popiku14/Project-1-audio-input-preamplifier/Layout/Layout.PNG

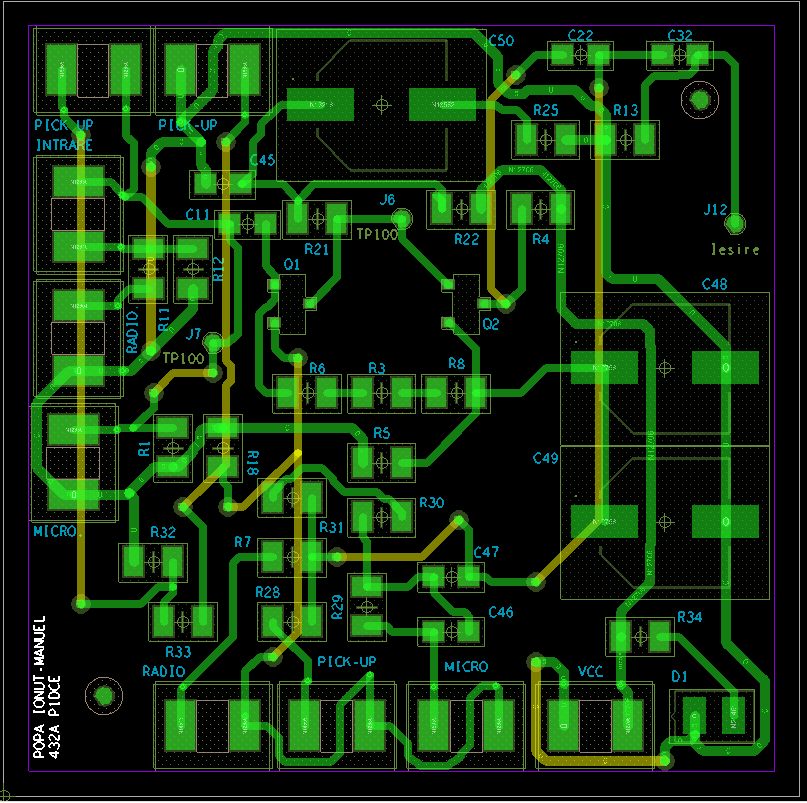
Layout/Layout.PNG
