popiku14/Project-1-audio-input-preamplifier/Schema Bloc.PNG

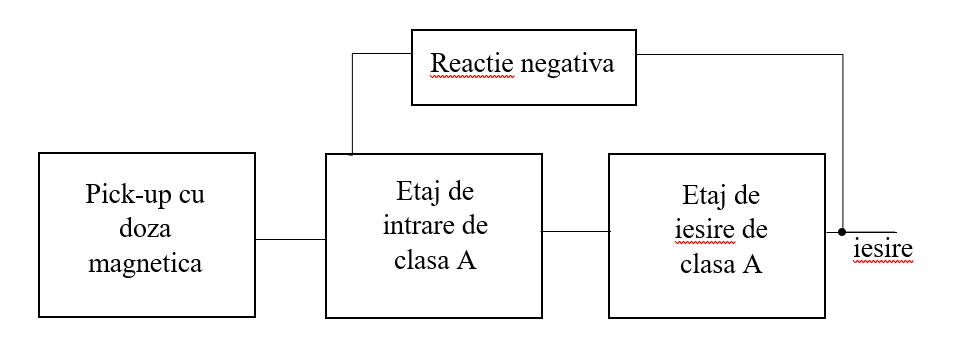
Schema Bloc.PNG
