popiku14/Project-1-audio-input-preamplifier/Simulations/simulare in frecventa.jpg

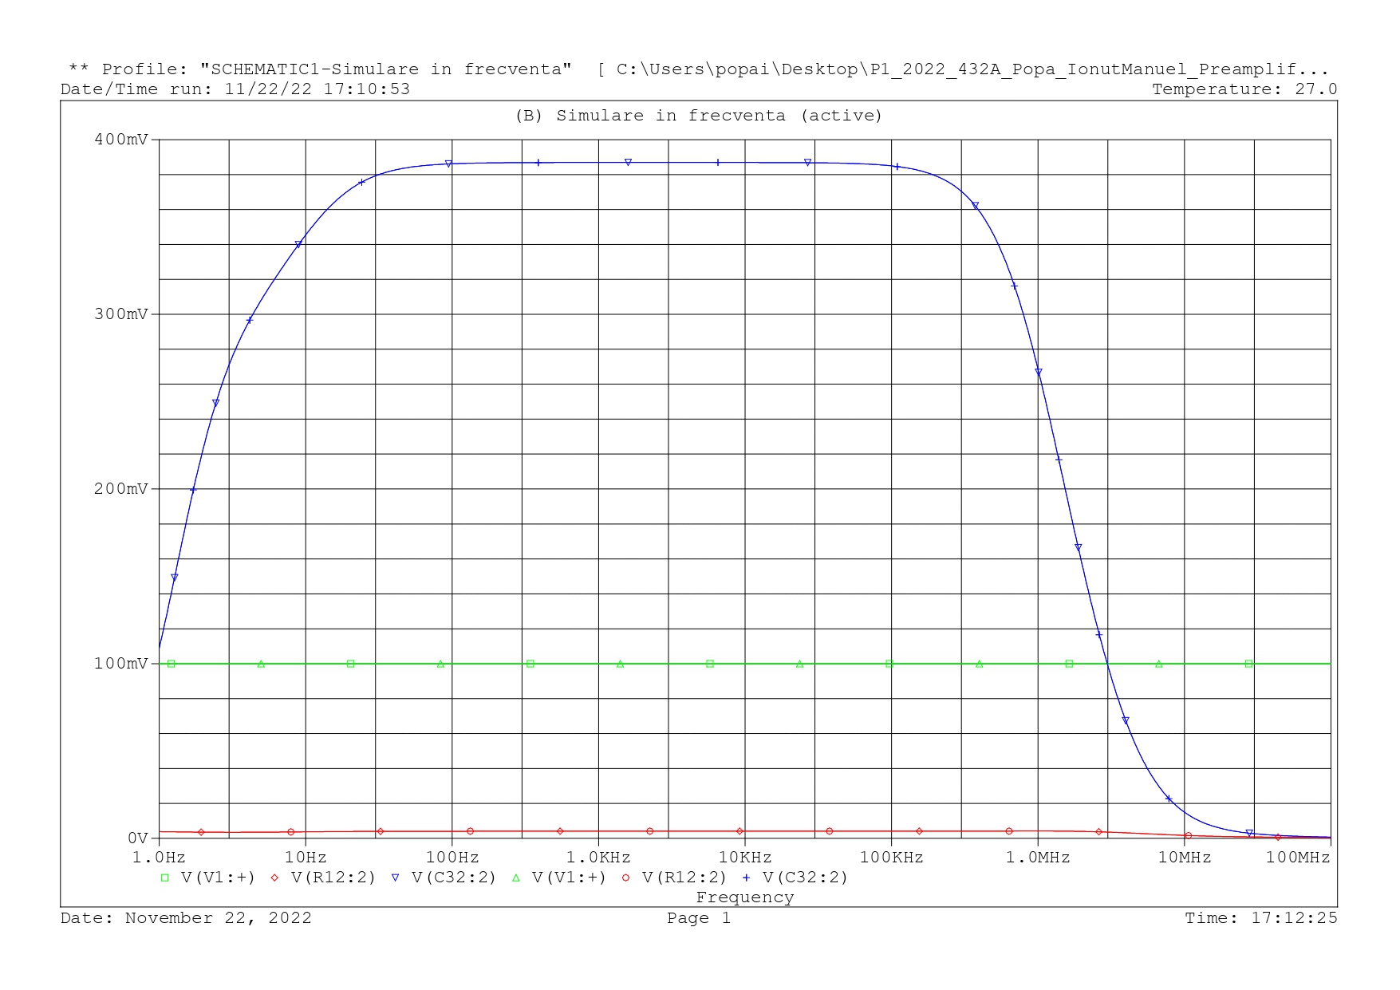
Simulations/simulare in frecventa.jpg
