popiku14/Project-1-audio-input-preamplifier/Simulations/simulare psf.png

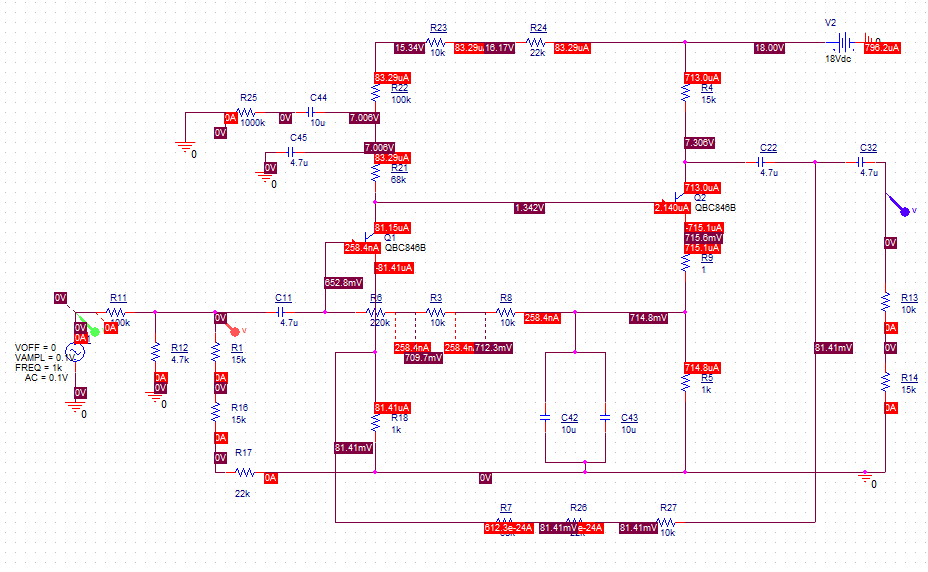
Simulations/simulare psf.png
