popiku14/Project-1-audio-input-preamplifier/Simulations/simulare tranzitorie (2).jpg

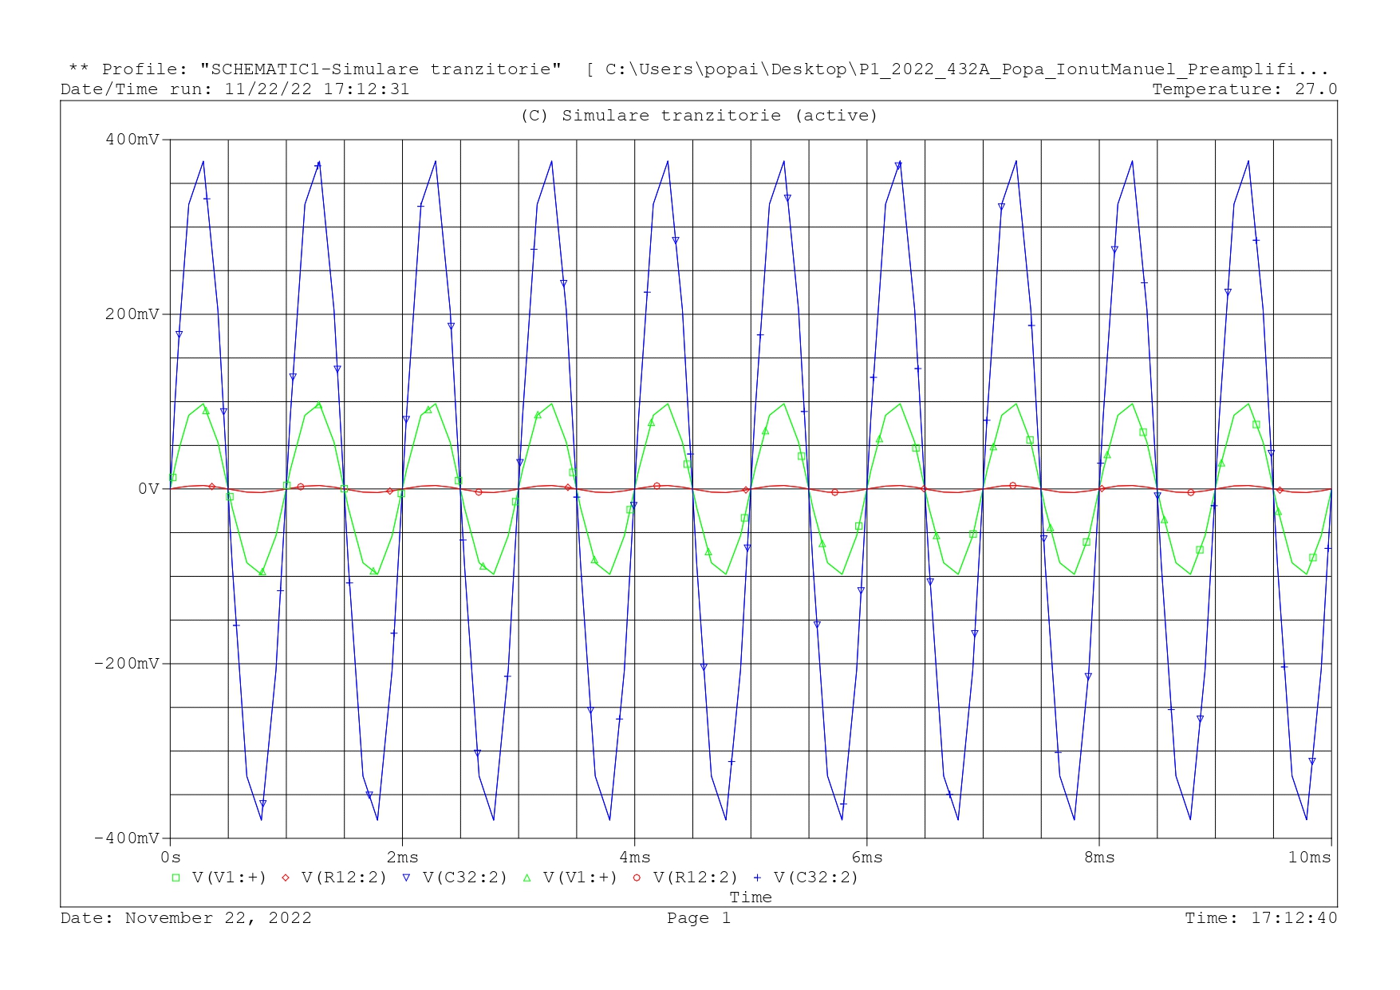
Simulations/simulare tranzitorie (2).jpg
