popiku14/Project-1-audio-input-preamplifier/Bill of materials/BOM.xlsx

Anexa a1 - Componente SMD disponibile pentru realizarea proiectului P1 - tehnologie SMT- AU 2021-2022
Nr. Crt. | Nume | Catalog | Cod distrib | Nume prod | Prod | Clasă | Descriere | Distribuitor | Cantitate
1 | 0 ohm | (LINK) (http://www.tme.eu/ro/details/smd1206-0r/rezistente-smd-1206/royal-ohm/1206s4j0000t5e/) | 1206S4J0000T5E | 1206S4J0000T5E | SR PASSIVES | rezistor | Rezistor: thick film; SMD; 1206; 0Ω; 0,25W; ±5%; -55÷125°C | TME România
2 | 0.47 | (LINK) (https://www.tme.eu/ro/details/0805s8j047kt5e/rezistente-smd-0805/royal-ohm/) | 0805S8J047KT5E | 0805S8J047KT5E | ROYAL OHM | rezistor | Rezistor: thick film; SMD; 0805; 470mΩ; 125mW; ±5%; -55÷125°C; 800ppm/°C | TME România
3 | 1 | (LINK) (https://www.tme.eu/ro/details/smd0805-1r/rezistente-smd-0805/royal-ohm/0805s8j010jt5e/) | SMD0805-1R | 0805S8J010JT5E | ROYAL OHM | rezistor | Rezistor: thick film; SMD; 0805; 1Ω; 0,125W; ±5%; -55÷125°C | TME România
4 | 4.7 | (LINK) (https://www.tme.eu/ro/details/smd0805-4r7/rezistente-smd-0805/royal-ohm/0805s8j047jt5e/) | SMD0805-4R7 | 0805S8J047JT5E | ROYAL OHM | rezistor | Rezistor: thick film; SMD; 0805; 4,7Ω; 0,125W; ±5%; -55÷125°C | TME România
5 | 10 | (LINK) (https://www.tme.eu/ro/details/smd0805-10r/rezistente-smd-0805/royal-ohm/0805s8j0100t5e/) | SMD0805-10R | 0805S8J0100T5E | ROYAL OHM | rezistor | Rezistor: thick film; SMD; 0805; 10Ω; 0,125W; ±5%; -55÷125°C | TME România
6 | 22 | (LINK) (https://www.tme.eu/ro/details/smd0805-22r-1%25/rezistente-smd-0805/royal-ohm/0805s8f220jt5e/) | SMD0805-22R-1% | 0805S8F220JT5E | ROYAL OHM | rezistor | Rezistor: thick film; SMD; 0805; 22Ω; 0,125W; ±1%; -55÷125°C | TME România
7 | 33 | (LINK) (https://www.tme.eu/ro/details/smd0805-33r/rezistente-smd-0805/royal-ohm/0805s8j0330t5e/) | SMD0805-33R | 0805S8J0330T5E | ROYAL OHM | rezistor | Rezistor: thick film; SMD; 0805; 33Ω; 0,125W; ±5%; -55÷125°C | TME România
8 | 51 | (LINK) (https://www.tme.eu/ro/details/0805s8j0510t5e/rezistente-smd-0805/royal-ohm/) | 0805S8J0510T5E | 0805S8J0510T5E | ROYAL OHM | rezistor | Rezistor: thick film; SMD; 0805; 51Ω; 0,125W; ±5%; -55÷155°C; 200ppm/°C | TME România
9 | 68 | (LINK) (https://www.tme.eu/ro/details/smd0805-68r/rezistente-smd-0805/royal-ohm/0805s8j0680t5e/) | SMD0805-68R | 0805S8J0680T5E | ROYAL OHM | rezistor | Rezistor: thick film; SMD; 0805; 68Ω; 0,125W; ±5%; -55÷125°C | TME România
10 | 82 | (LINK) (https://www.tme.eu/ro/details/smd0805-82r/rezistente-smd-0805/royal-ohm/0805s8j0820t5e/) | SMD0805-82R | 0805S8J0820T5E | ROYAL OHM | rezistor | Rezistor: thick film; SMD; 0805; 82Ω; 0,125W; ±5%; -55÷125°C | TME România
11 | 100 | (LINK) (https://www.tme.eu/ro/details/smd0805-100r/rezistente-smd-0805/royal-ohm/0805s8j0101t5e/) | SMD0805-100R | 0805S8J0101T5E | ROYAL OHM | rezistor | Rezistor: thick film; SMD; 0805; 100Ω; 0,125W; ±5%; -55÷125°C | TME România
12 | 150 | (LINK) (https://www.tme.eu/ro/details/smd0805-150r/rezistente-smd-0805/royal-ohm/0805s8j0151t5e/) | SMD0805-150R | 0805S8J0151T5E | ROYAL OHM | rezistor | Rezistor: thick film; SMD; 0805; 150Ω; 0,125W; ±5%; -55÷125°C | TME România
13 | 220 | (LINK) (https://www.tme.eu/ro/details/smd0805-220r/rezistente-smd-0805/royal-ohm/0805s8j0221t5e/) | SMD0805-220R | 0805S8J0221T5E | ROYAL OHM | rezistor | Rezistor: thick film; SMD; 0805; 220Ω; 0,125W; ±5%; -55÷125°C | TME România
14 | 330 | (LINK) (https://www.tme.eu/ro/details/smd0805-330r/rezistente-smd-0805/royal-ohm/0805s8j0331t5e/) | SMD0805-330R | 0805S8J0331T5E | ROYAL OHM | rezistor | Rezistor: thick film; SMD; 0805; 330Ω; 0,125W; ±5%; -55÷125°C | TME România
15 | 470 | (LINK) (https://www.tme.eu/ro/details/smd0805-470r/rezistente-smd-0805/royal-ohm/0805s8j0471t5e/) | SMD0805-470R | 0805S8J0471T5E | ROYAL OHM | rezistor | Rezistor: thick film; SMD; 0805; 470Ω; 0,125W; ±5%; -55÷125°C | TME România
16 | 510 | (LINK) (https://www.tme.eu/ro/details/smd0805-510r/rezistente-smd-0805/royal-ohm/0805s8j0511t5e/) | SMD0805-510R | 0805S8J0511T5E | ROYAL OHM | rezistor | Rezistor: thick film; SMD; 0805; 510Ω; 0,125W; ±5%; -55÷125°C | TME România
17 | 680 | (LINK) (https://www.tme.eu/ro/details/smd0805-680r/rezistente-smd-0805/royal-ohm/0805s8j0681t5e/) | SMD0805-680R | 0805S8J0681T5E | ROYAL OHM | rezistor | Rezistor: thick film; SMD; 0805; 680Ω; 0,125W; ±5%; -55÷125°C | TME România
18 | 820 | (LINK) (https://www.tme.eu/ro/details/smd0805-820r/rezistente-smd-0805/royal-ohm/0805s8j0821t5e/) | SMD0805-820R | 0805S8J0821T5E | ROYAL OHM | rezistor | Rezistor: thick film; SMD; 0805; 820Ω; 0,125W; ±5%; -55÷125°C | TME România
19 | 910 | (LINK) (https://www.tme.eu/ro/details/smd0805-910r/rezistente-smd-0805/royal-ohm/0805s8j0911t5e/) | SMD0805-910R | 0805S8J0911T5E | ROYAL OHM | rezistor | Rezistor: thick film; SMD; 0805; 910Ω; 0,125W; ±5%; -55÷125°C | TME România
20 | 1k | (LINK) (https://www.tme.eu/ro/details/smd0805-1k/rezistente-smd-0805/royal-ohm/0805s8j0102t5e/) | SMD0805-1K | 0805S8J0102T5E | ROYAL OHM | rezistor | Rezistor: thick film; SMD; 0805; 1kΩ; 0,125W; ±5%; -55÷125°C | TME România | 3
21 | 1.5k | (LINK) (https://www.tme.eu/ro/details/smd0805-1k5/rezistente-smd-0805/royal-ohm/0805s8j0152t5e/) | SMD0805-1K5 | 0805S8J0152T5E | ROYAL OHM | rezistor | Rezistor: thick film; SMD; 0805; 1,5kΩ; 0,125W; ±5%; -55÷125°C | TME România
22 | 1.8k | (LINK) (https://www.tme.eu/ro/details/smd0805-1k8/rezistente-smd-0805/royal-ohm/0805s8j0182t5e/) | SMD0805-1K8 | 0805S8J0182T5E | ROYAL OHM | rezistor | Rezistor: thick film; SMD; 0805; 1,8kΩ; 0,125W; ±5%; -55÷125°C | TME România
23 | 2k | (LINK) (https://www.tme.eu/ro/details/smd0805-2k/rezistente-smd-0805/royal-ohm/0805s8j0202t5e/) | SMD0805-2K | 0805S8J0202T5E | ROYAL OHM | rezistor | Rezistor: thick film; SMD; 0805; 2kΩ; 0,125W; ±5%; -55÷125°C | TME România
24 | 2.2k | (LINK) (https://www.tme.eu/ro/details/smd0805-2k2/rezistente-smd-0805/royal-ohm/0805s8j0222t5e/) | SMD0805-2K2 | 0805S8J0222T5E | ROYAL OHM | rezistor | Rezistor: thick film; SMD; 0805; 2,2kΩ; 0,125W; ±5%; -55÷125°C | TME România
25 | 2.7k | (LINK) (https://www.tme.eu/ro/details/smd0805-2k7/rezistente-smd-0805/royal-ohm/0805s8j0272t5e/) | SMD0805-2K7 | 0805S8J0272T5E | ROYAL OHM | rezistor | Rezistor: thick film; SMD; 0805; 2,7kΩ; 0,125W; ±5%; -55÷125°C | TME România
26 | 3.3k | (LINK) (https://www.tme.eu/ro/details/smd0805-3k3/rezistente-smd-0805/royal-ohm/0805s8j0332t5e/) | SMD0805-3K3 | 0805S8J0332T5E | ROYAL OHM | rezistor | Rezistor: thick film; SMD; 0805; 3,3kΩ; 0,125W; ±5%; -55÷125°C | TME România
27 | 3.9k | (LINK) (https://www.tme.eu/ro/details/smd0805-3k9/rezistente-smd-0805/royal-ohm/0805s8j0392t5e/) | SMD0805-3K9 | 0805S8J0392T5E | ROYAL OHM | rezistor | Rezistor: thick film; SMD; 0805; 3,9kΩ; 0,125W; ±5%; -55÷125°C | TME România
28 | 4.7k | (LINK) (https://www.tme.eu/ro/details/smd0805-4k7/rezistente-smd-0805/royal-ohm/0805s8j0472t5e/) | SMD0805-4K7 | 0805S8J0472T5E | ROYAL OHM | rezistor | Rezistor: thick film; SMD; 0805; 4,7kΩ; 0,125W; ±5%; -55÷125°C | TME România | 1
29 | 5.6k | (LINK) (https://www.tme.eu/ro/details/smd0805-5k6/rezistente-smd-0805/royal-ohm/0805s8j0562t5e/) | SMD0805-5K6 | 0805S8J0562T5E | ROYAL OHM | rezistor | Rezistor: thick film; SMD; 0805; 5,6kΩ; 0,125W; ±5%; -55÷125°C | TME România
30 | 6.8k | (LINK) (https://www.tme.eu/ro/details/smd0805-6k8-1%25/rezistente-smd-0805/royal-ohm/0805s8f6801t5e/) | SMD0805-6K8-1% | 0805S8F6801T5E | ROYAL OHM | rezistor | Rezistor: thick film; SMD; 0805; 6,8kΩ; 0,125W; ±1%; -55÷125°C | TME România
31 | 8.2k | (LINK) (https://www.tme.eu/ro/details/smd0805-8k2/rezistente-smd-0805/royal-ohm/0805s8j0822t5e/) | SMD0805-8K2 | 0805S8J0822T5E | ROYAL OHM | rezistor | Rezistor: thick film; SMD; 0805; 8,2kΩ; 0,125W; ±5%; -55÷125°C | TME România
32 | 9.1k | (LINK) (https://www.tme.eu/ro/details/smd0805-9k1/rezistente-smd-0805/royal-ohm/0805s8j0912t5e/) | SMD0805-9K1 | 0805S8J0912T5E | ROYAL OHM | rezistor | Rezistor: thick film; SMD; 0805; 9,1kΩ; 0,125W; ±5%; -55÷125°C | TME România
33 | 10k | (LINK) (https://www.tme.eu/ro/details/smd0805-10k/rezistente-smd-0805/royal-ohm/0805s8j0103t5e/) | SMD0805-10K | 0805S8J0103T5E | ROYAL OHM | rezistor | Rezistor: thick film; SMD; 0805; 10kΩ; 0,125W; ±5%; -55÷125°C | TME România | 2
34 | 15k | (LINK) (https://www.tme.eu/ro/details/smd0805-15k/rezistente-smd-0805/royal-ohm/0805s8j0153t5e/) | SMD0805-15K | 0805S8J0153T5E | ROYAL OHM | rezistor | Rezistor: thick film; SMD; 0805; 15kΩ; 0,125W; ±5%; -55÷125°C | TME România | 2
35 | 22k | (LINK) (https://www.tme.eu/ro/details/smd0805-22k/rezistente-smd-0805/royal-ohm/0805s8j0223t5e/) | SMD0805-22K | 0805S8J0223T5E | ROYAL OHM | rezistor | Rezistor: thick film; SMD; 0805; 22kΩ; 0,125W; ±5%; -55÷125°C | TME România | 1
36 | 47k | (LINK) (http://www.tme.eu/ro/details/smd0805-47k/rezistente-smd-0805/royal-ohm/0805s8j0473t5e/) | SMD0805-47K | 0805S8J0473T5E | ROYAL OHM | rezistor | Rezistor: thick film; SMD; 0805; 47kΩ; 0,125W; ±5%; -55÷125°C | TME România | 1
37 | 68k | (LINK) (https://www.tme.eu/ro/details/smd0805-68k/rezistente-smd-0805/royal-ohm/0805s8j0683t5e/) | SMD0805-68K | 0805S8J0683T5E | ROYAL OHM | rezistor | Rezistor: thick film; SMD; 0805; 68kΩ; 0,125W; ±5%; -55÷125°C | TME România | 2
38 | 100k | (LINK) (https://www.tme.eu/ro/details/smd0805-100k/rezistente-smd-0805/royal-ohm/0805s8j0104t5e/) | SMD0805-100K | 0805S8J0104T5E | ROYAL OHM | rezistor | Rezistor: thick film; SMD; 0805; 100kΩ; 0,125W; ±5%; -55÷125°C | TME România | 2
39 | 150k | (LINK) (http://www.tme.eu/ro/details/smd0805-150k/rezistente-smd-0805/royal-ohm/0805s8j0154t5e/) | SMD0805-150K | 0805S8J0154T5E | ROYAL OHM | rezistor | Rezistor: thick film; SMD; 0805; 150kΩ; 0,125W; ±5%; -55÷125°C | TME România | 1
40 | 180k | (LINK) (https://www.tme.eu/ro/details/smd0805-180k-1%25/rezistente-smd-0805/royal-ohm/0805s8f1803t5e/) | SMD0805-180K-1% | 0805S8F1803T5E | ROYAL OHM | rezistor | Rezistor: thick film; SMD; 0805; 180kΩ; 0,125W; ±1%; -55÷125°C | TME România
41 | 220k | (LINK) (https://www.tme.eu/ro/details/smd0805-220k/rezistente-smd-0805/royal-ohm/0805s8j0224t5e/) | SMD0805-220K | 0805S8J0224T5E | ROYAL OHM | rezistor | Rezistor: thick film; SMD; 0805; 220kΩ; 0,125W; ±5%; -55÷125°C | TME România | 2
42 | 330k | (LINK) (https://www.tme.eu/ro/details/smd0805-330k-1%25/rezistente-smd-0805/royal-ohm/0805s8f3303t5e/) | SMD0805-330K-1% | 0805S8F3303T5E | ROYAL OHM | rezistor | Rezistor: thick film; SMD; 0805; 330kΩ; 0,125W; ±1%; -55÷125°C | TME România | 1
43 | 390k | (LINK) (https://www.tme.eu/ro/details/smd0805-390k/rezistente-smd-0805/royal-ohm/0805s8j0394t5e/) | SMD0805-390K | 0805S8J0394T5E | ROYAL OHM | rezistor | Rezistor: thick film; SMD; 0805; 390kΩ; 0,125W; ±5%; -55÷125°C | TME România
44 | 510k | (LINK) (https://www.tme.eu/ro/details/smd0805-510k/rezistente-smd-0805/royal-ohm/0805s8j0514t5e/) | SMD0805-510K | 0805S8J0514T5E | ROYAL OHM | rezistor | Rezistor: thick film; SMD; 0805; 510kΩ; 0,125W; ±5%; -55÷125°C | TME România | 1
45 | 1M | (LINK) (https://www.tme.eu/ro/details/smd0805-1m-1%25/rezistente-smd-0805/royal-ohm/0805s8f1004t5e/) | SMD0805-1M-1% | 0805S8F1004T5E | ROYAL OHM | rezistor | Rezistor: thick film; SMD; 0805; 1MΩ; 0,125W; ±1%; -55÷125°C | TME România | 2
46 | 2M | (LINK) (http://www.tme.eu/ro/details/smd0805-2m/rezistente-smd-0805/royal-ohm/0805waj-2m-t5e/) | SMD0805-2M | 0805S8J0205T5E | ROYAL OHM | rezistor | Rezistor: thick film; SMD; 0805; 2MΩ; 0,125W; ±5%; -55÷125°C | TME România
47 | 5,1M | (LINK) (http://www.tme.eu/ro/details/smd0805-5m1/rezistente-smd-0805/royal-ohm/0805s8j0515t5e/) | SMD0805-5M1 | 0805S8J0515T5E | ROYAL OHM | rezistor | Rezistor: thick film; SMD; 0805; 5,1MΩ; 0,125W; ±5%; -55÷125°C | TME România
48 | 10M | (LINK) (https://www.tme.eu/ro/details/smd0805-10m/rezistente-smd-0805/royal-ohm/0805s8j0106t5e/) | SMD0805-10M | 0805S8J0106T5E | ROYAL OHM | rezistor | Rezistor: thick film; SMD; 0805; 10MΩ; 0,125W; ±5%; -55÷125°C | TME România
49 | 100ohm | (LINK) (https://www.tme.eu/ro/details/ts53yl100r/trimere-smd-cu-o-singura-tura/vishay/ts53yl101mr10/) | TS53YL100R | TS53YL101MR10 | VISHAY | potențiometru | Potenţiometru: de montare; singură tură; 100Ω; 250mW; SMD; ±20%; 100ppm/°C | TME România
50 | 500ohm | (LINK) (https://www.tme.eu/ro/details/ts53yl500r/trimere-smd-cu-o-singura-tura/vishay/ts53yl501mr10/) | TS53YL500R | TS53YL501MR10 | VISHAY | potențiometru | Potenţiometru: de montare; singură tură; 500Ω; 250mW; SMD; ±20%; 100ppm/°C | TME România
51 | 2k | (LINK) (https://www.tme.eu/ro/details/3314g-1-202e/trimere-smd-cu-o-singura-tura/bourns/) | 3314G-1-202E | 3314G-1-202E | BOURNS | potențiometru | Potenţiometru: de montare; singură tură,orizontal; 2kΩ; 250mW; SMD; ±20%, 100ppm/°C | TME România
52 | 5k | (LINK) (https://www.tme.eu/ro/details/ts53yl5k/trimere-smd-cu-o-singura-tura/vishay/ts53yl502mr10/) | TS53YL5K | TS53YL502MR10 | VISHAY | potențiometru | Potenţiometru: de montare; singură tură; 5kΩ; 250mW; SMD; ±20%; 100ppm/°C | TME România
53 | 10k | (LINK) (https://www.tme.eu/ro/details/ts53yl10k/trimere-smd-cu-o-singura-tura/vishay/ts53yl103mr10/) | TS53YL10K | TS53YL103MR10 | VISHAY | potențiometru | Potenţiometru: de montare; singură tură; 10kΩ; 250mW; SMD; ±20%; 100ppm/°C | TME România
54 | 50k | (LINK) (https://www.tme.eu/ro/details/ts53yl50k/trimere-smd-cu-o-singura-tura/vishay/ts53yl503mr10/) | TS53YL50K | TS53YL503MR10 | VISHAY | potențiometru | Potenţiometru: de montare; singură tură; 50kΩ; 250mW; SMD; ±20%; 100ppm/°C | TME România
55 | 100k | (LINK) (http://www.tme.eu/ro/details/ts53yl100k/trimere-smd-cu-o-singura-tura/vishay/ts53yl104mr10/) | TS53YL100K | TS53YL104MR10 | VISHAY | potențiometru | Potenţiometru: de montare; singură tură; 100kΩ; 250mW; SMD; ±20%; 100ppm/°C | TME România
56 | 500k | (LINK) (http://www.tme.eu/ro/details/3314g-1-504e/trimere-smd-cu-o-singura-tura/bourns/) | 3314G-1-504E | 3314G-1-504E | BOURNS | potențiometru | Potenţiometru: de montare; singură tură,orizontal; 500kΩ; 250mW; SMD; ±20%; 100ppm/°C | TME România
 | TOTAL - Componente pasive (rezistoare de valori fixe şi reglabile) |  |  |  |  |  | FARA TVA = | 0 | 21
57 | 4.7pF | (LINK) (https://www.tme.eu/ro/details/cl21c4r7cbannnc/condensatoare-mlcc-smd-0805/samsung/) | CL21C4R7CBANNNC | CL21C4R7CBANNNC | SAMSUNG | condensator | ceramic; MLCC; 4,7pF; 50V; C0G; ±0,25pF; SMD; 0805 | TME România
58 | 10pF | (LINK) (https://www.tme.eu/ro/details/cl21c100jbannnc/condensatoare-mlcc-smd-0805/samsung/) | CL21C100JBANNNC | CL21C100JBANNNC | SAMSUNG | condensator | ceramic; MLCC; 10pF; 50V; C0G; ±5%; SMD; 0805 | TME România
59 | 47pF | (LINK) (http://www.tme.eu/ro/details/cl21c470jbannnc/condensatoare-mlcc-smd-0805/samsung/) | CL21C470JBANNNC | CL21C470JBANNNC | SAMSUNG | condensator | Condensator: ceramic; MLCC; 47pF; 50V; C0G; ±5%; SMD; 0805; -55÷125°C | TME România
60 | 100pF | (LINK) (http://www.tme.eu/ro/details/cl21c101jbannnc/condensatoare-mlcc-smd-0805/samsung/) | CL21C101JBANNNC | CL21C101JBANNNC | SAMSUNG | condensator | Condensator: ceramic; MLCC; 100pF; 50V; C0G; ±5%; SMD; 0805 | TME România
61 | 470pF | (LINK) (https://www.tme.eu/ro/details/cl21c471jbannnc/condensatoare-mlcc-smd-0805/samsung/) | CL21C471JBANNNC | CL21C471JBANNNC | SAMSUNG | condensator | Condensator: ceramic; MLCC; 470pF; 50V; C0G; ±5%; SMD; 0805 | TME România
62 | 1nF | (LINK) (https://www.tme.eu/ro/details/cl21c102jbcnnnc/condensatoare-mlcc-smd-0805/samsung/) | CL21C102JBCNNNC | CL21C102JBCNNNC | SAMSUNG | condensator | Condensator: ceramic; MLCC; 1nF; 50V; C0G; ±5%; SMD; 0805 | TME România | 1
63 | 2.2nF | (LINK) (https://www.tme.eu/ro/details/cl21b222kbannnc/condensatoare-mlcc-smd-0805/samsung/) | CL21B222KBANNNC | CL21B222KBANNNC | SAMSUNG | condensator | Condensator: ceramic; MLCC; 2,2nF; 50V; X7R; ±10%; SMD; 0805 | TME România
64 | 4.7nF | (LINK) (https://www.tme.eu/ro/details/cl21b472kbannnc/condensatoare-mlcc-smd-0805/samsung/) | CL21B472KBANNNC | CL21B472KBANNNC | SAMSUNG | condensator | Condensator: ceramic; MLCC; 4,7nF; 50V; X7R; ±10%; SMD; 0805 | TME România | 1
65 | 5.6nF | (LINK) (https://www.tme.eu/ro/details/cl21b562kbannnc/condensatoare-mlcc-smd-0805/samsung/) | CL21B562KBANNNC | CL21B562KBANNNC | SAMSUNG | condensator | Condensator: ceramic; MLCC; 5,6nF; 50V; X7R; ±10%; SMD; 0805 | TME România
66 | 10nF | (LINK) (https://www.tme.eu/ro/details/cl21b103kbannnc/condensatoare-mlcc-smd-0805/samsung/) | CL21B103KBANNNC | CL21B103KBANNNC | SAMSUNG | condensator | Condensator: ceramic; MLCC; 10nF; 50V; X7R; ±10%; SMD; 0805 | TME România
67 | 22nF | (LINK) (https://www.tme.eu/ro/details/cl21b223kbannnc/condensatoare-mlcc-smd-0805/samsung/) | CL21B223KBANNNC | CL21B223KBANNNC | SAMSUNG | condensator | Condensator: ceramic; MLCC; 22nF; 50V; X7R; ±10%; SMD; 0805 | TME România
68 | 33nF | (LINK) (https://www.tme.eu/ro/details/cl21b333jbannnc/condensatoare-mlcc-smd-0805/samsung/) | CL21B333JBANNNC | CL21B333JBANNNC | SAMSUNG | condensator | Condensator: ceramic; MLCC; 33nF; 50V; X7R; ±5%; SMD; 0805 | TME România
69 | 100nF | (LINK) (https://www.tme.eu/ro/details/cl21b104jbcnnnc/condensatoare-mlcc-smd-0805/samsung/) | CL21B104JBCNNNC | CL21B104JBCNNNC | SAMSUNG | condensator | Condensator: ceramic; MLCC; 100nF; 50V; X7R; ±5%; SMD; 0805 | TME România
70 | 220nF | (LINK) (https://www.tme.eu/ro/details/cl21b224kbfnnng/condensatoare-mlcc-smd-0805/samsung/) | CL21B224KBFNNNG | CL21B224KBFNNNG | SAMSUNG | condensator | Condensator: ceramic; MLCC; 220nF; 50V; X7R; ±10%; SMD; 0805 | TME România
71 | 330nF | (LINK) (https://www.tme.eu/ro/details/cl21b334kbfnnne/condensatoare-mlcc-smd-0805/samsung/) | CL21B334KBFNNNE | CL21B334KBFNNNE | SAMSUNG | condensator | Condensator: ceramic; MLCC; 330nF; 50V; X7R; ±10%; SMD; 0805 | TME România
72 | 470nF | (LINK) (https://www.tme.eu/ro/details/cl21b474kbfnnne/condensatoare-mlcc-smd-0805/samsung/) | CL21B474KBFNNNE | CL21B474KBFNNNE | SAMSUNG | condensator | Condensator: ceramic; MLCC; 470nF; 50V; X7R; ±10%; SMD; 0805 | TME România
73 | 1uF | (LINK) (https://www.tme.eu/ro/details/cl21b105kbfnnng/condensatoare-mlcc-smd-0805/samsung/) | CL21B105KBFNNNG | CL21B105KBFNNNG | SAMSUNG | condensator | Condensator: ceramic; MLCC; 1uF; 50V; X7R; ±10%; SMD; 0805 | TME România
74 | 2.2uF | (LINK) (https://www.tme.eu/ro/details/grm21br61h225ka73l/condensatoare-mlcc-smd-0805/murata/) | GRM21BR61H225KA73L | GRM21BR61H225KA73L | MURATA | condensator | Condensator: ceramic; MLCC; 2,2uF; 50V; X5R; ±10%; SMD; 0805 | TME România
75 | 4.7uF | (LINK) (https://www.tme.eu/ro/details/cl21a475kaqnnng/condensatoare-mlcc-smd-0805/samsung/) | CL21A475KAQNNNG | CL21A475KAQNNNG | SAMSUNG | condensator | Condensator: ceramic; MLCC; 4,7uF; 25V; X5R; ±10%; SMD; 0805 | TME România | 4
76 | 10uF | (LINK) (https://www.tme.eu/ro/details/sc1h106m6l005vr/condensatoare-electrolitice-smd-85degc/samwha/) | SC1H106M6L005VR | SC1H106M6L005VR | SAMWHA | condensator | Condensator: electrolitic; SMD; 10uF; 50VDC; Ø6,3x5,3mm; ±20% | TME România | 3
 | TOTAL - Componente pasive (condensatoare) |  |  |  |  |  | FARA TVA = | 0 | 9
77 | 4148 | (LINK) (https://www.tme.eu/ro/details/ts4148-ryg/diode-universale-smd/taiwan-semiconductor/ts4148-ryg/) | TS4148-RYG | TS4148 RYG | TAIWAN SEMICONDUCTOR | diodă pn | Diodă: comutaţie; SMD; 100V; 0,15A; 4ns; Ambalaj: rolă,bandă; 0805 | TME România
78 | LED | (LINK) (https://www.tme.eu/ro/details/of-smd2012g/diode-led-smd-colorate/optoflash/) | OF-SMD2012G | OF-SMD2012G | OPTOFLASH | LED | LED; SMD; 0805; verde; 50÷100mcd; 2x1,25x0,68mm; 120°; 1,8÷2V; 20mA | TME România | 1
79 | 2.7V | (LINK) (http://www.tme.eu/ro/details/bzx84c2v7/diode-zener-smd/on-semiconductor/bzx84c2v7lt1g/) | BZX84C2V7 | BZX84-C2V7LT1G | ON Semiconductor | diodă Zener | Diodă Zener, SMD, SOT23, 2,7V, ±5%, 0.25W | TME România
80 | 5.1V | (LINK) (https://www.tme.eu/ro/details/bzx84-c5v1.215/diode-zener-smd/nexperia/) | BZX84-C5V1.215 | BZX84-C5V1.215 | NEXPERIA | diodă Zener | Diodă: Zener; 0,25W; 5,1V; SMD; rolă,bandă; SOT23; Ifmax: 200mA | TME România
81 | 5.6V | (LINK) (https://www.tme.eu/ro/details/bzx84b5v6-dio/diode-zener-smd/diotec-semiconductor/bzx84b5v6/) | BZX84B5V6-DIO | BZX84B5V6 | DIOTEC SEMICONDUCTOR | diodă Zener | Diodă Zener, SMD, SOT23, 5,6V, ±5%, 0.3W | TME România
82 | 6.2V | (LINK) (https://www.tme.eu/ro/details/bzx84-c6v2.215/diode-zener-smd/nexperia/) | BZX84-C6V2.215 | BZX84-C6V2.215 | NEXPERIA | diodă Zener | Diodă Zener, SMD, SOT23, 6.2V, ±5%, 0.25W, Ifmax: 200mA | TME România
83 | 6.8V | (LINK) (https://www.tme.eu/ro/details/bzx84-c6v8.215/diode-zener-smd/nexperia/) | BZX84-C6V8.215 | BZX84-C6V8.215 | NEXPERIA | diodă Zener | Diodă Zener, SMD, SOT23, 6.8V, ±5%, 0.25W, Ifmax: 200mA | TME România
84 | 8.2V | (LINK) (https://www.tme.eu/ro/details/bzx84-c8v2.215/diode-zener-smd/nexperia/) | BZX84-C8V2.215 | BZX84-C8V2.215 | NEXPERIA | diodă Zener | Diodă Zener, SMD, SOT23, 8.2V, ±5%, 0.25W, Ifmax: 200mA | TME România
85 | 10V | (LINK) (https://www.tme.eu/ro/details/bzx84-c10.215/diode-zener-smd/nexperia/) | BZX84-C10.215 | BZX84-C10.215 | NEXPERIA | diodă Zener | Diodă Zener, SMD, SOT23, 10V, ±5%, 0.25W, Ifmax: 200mA | TME România
86 | PNP | (LINK) (http://www.tme.eu/ro/details/bc856b-dio/tranzistori-smd-pnp/diotec-semiconductor/bc856b/) | BC856B-DIO | BC856B | DIOTEC SEMICONDUCTOR | tranzistor bipolar | Tranzistor bipolar PNP, SMD, SOT23, 65V, 100mA, 250mW | TME România
87 | NPN | (LINK) (https://www.tme.eu/ro/details/bc846b-dio/tranzistori-smd-npn/diotec-semiconductor/bc846b/) | BC846B-DIO | BC846B | DIOTEC SEMICONDUCTOR | tranzistor bipolar | Tranzistor bipolar NPN, SMD, SOT23, 65V, 100mA, 250mW | TME România | 2
89 | N-JFET | (LINK) (http://www.tme.eu/ro/details/mmbfj309lt1g/tranzistori-canal-n-smd/on-semiconductor/) | MMBFJ309LT1G | MMBFJ309LT1G | ON Semiconductor | tranzistor NJFET | Tranzistor: N-JFET; unipolar; 25V; 30mA; 225mW; SMD SOT23; Igt: 10mA | TME România
90 | P-JFET | (LINK) (http://www.tme.eu/ro/details/mmbfj177lt1g/tranzistori-canal-p-smd/on-semiconductor/) | MMBFJ177LT1G | MMBFJ177LT1G | ON Semiconductor | tranzistor PJFET | Tranzistor: P-JFET; unipolar; 20mA; 30V; 225mW; SMD SOT23 | TME România
91 | NPN | (LINK) (http://www.tme.eu/ro/details/bc817-25-dio/tranzistori-smd-npn/diotec-semiconductor/bc817-25/) | BC817-25-DIO | BC817-25 | DIOTEC SEMICONDUCTOR | tranzistor bipolar | Tranzistor bipolar NPN, SMD, SOT23, 45V, 800mA | TME România
93 | PNP | (LINK) (http://www.tme.eu/ro/details/bc807-25-dio/tranzistori-smd-pnp/diotec-semiconductor/bc807-25/) | BC807-25-DIO | BC807-25 | DIOTEC SEMICONDUCTOR | tranzistor bipolar | Tranzistor bipolar PNP, SMD, SOT23, 45V, 800mA | TME România
94 | NPN | (LINK) (http://www.tme.eu/ro/details/mjd31cg/tranzistori-smd-npn/on-semiconductor/) | MJD31CG | MJD31CG | ON Semiconductor | tranzistor bipolar | Tranzistor bipolar NPN, SMD, DPACK, 100V, 3A, 15W | TME România
96 | PNP | (LINK) (https://www.tme.eu/ro/details/mjd32ct4/tranzistori-smd-pnp/stmicroelectronics/) | MJD32CT4 | MJD32CT4 | STMICROELECTRONICS | tranzistor bipolar | Tranzistor bipolar PNP, SMD, DPACK, 100V, 3A, 15W | TME România
97 | Nmos | (LINK) (https://www.tme.eu/ro/details/irfr120ntrpbf/tranzistori-canal-n-smd/infineon-irf/) | IRFR120NTRPBF | IRFR120NTRPBF | INFINEON (IRF) | tranzistor NMOS | Tranzistor N-MOSFET, unipolar, SMD, DPAK, 100V, 9.1A, 39W | TME România
 | TOTAL - Componente semiconductoare (tranzistoare bipolare şi cu efect de câmp, diode, LED, etc.) |  |  |  |  |  | FARA TVA = | 0 | 3
98 | Conn2p | (LINK) (http://www.tme.eu/ro/details/zl301-40p/pini-cu-benzi-si-soclu/ninigi/) | ZL301-40P | ZL301-40P | NINIGI | Sir pini, pas 2,54mm, SMD | Sir pini, pas 2,54mm, SMD, tip tata, bareta de 40 pini | TME România | indisponibil
99 | FUSE | (LINK) (http://www.tme.eu/ro/details/3413.0116.11/sigurante-smd-1206-ultrarapide/schurter/) | 3413.0116.11 | 3413.0116.11 | SCHURTER | sigu-ranță | Siguranță sticlă, SMD, 1206, 1.25A, 48mΩ | TME România | indisponibil
 | Total - Conectică, sigurante fuzibile, etc. |  |  |  |  |  | FARA TVA = | 0
 | Total general |  |  |  |  |  | FARA TVA = | 0 | 33
