popiku14/Project-1-audio-input-preamplifier/(list of files, drawings)

Other design files:
Schematics/PROIECT-PCB.DSN
Schematics/PROIECT-PCB.opj
